scott-williams-xentronics/CanberraGrammarSchool-OrienteeringDevice/Schematic.pdf

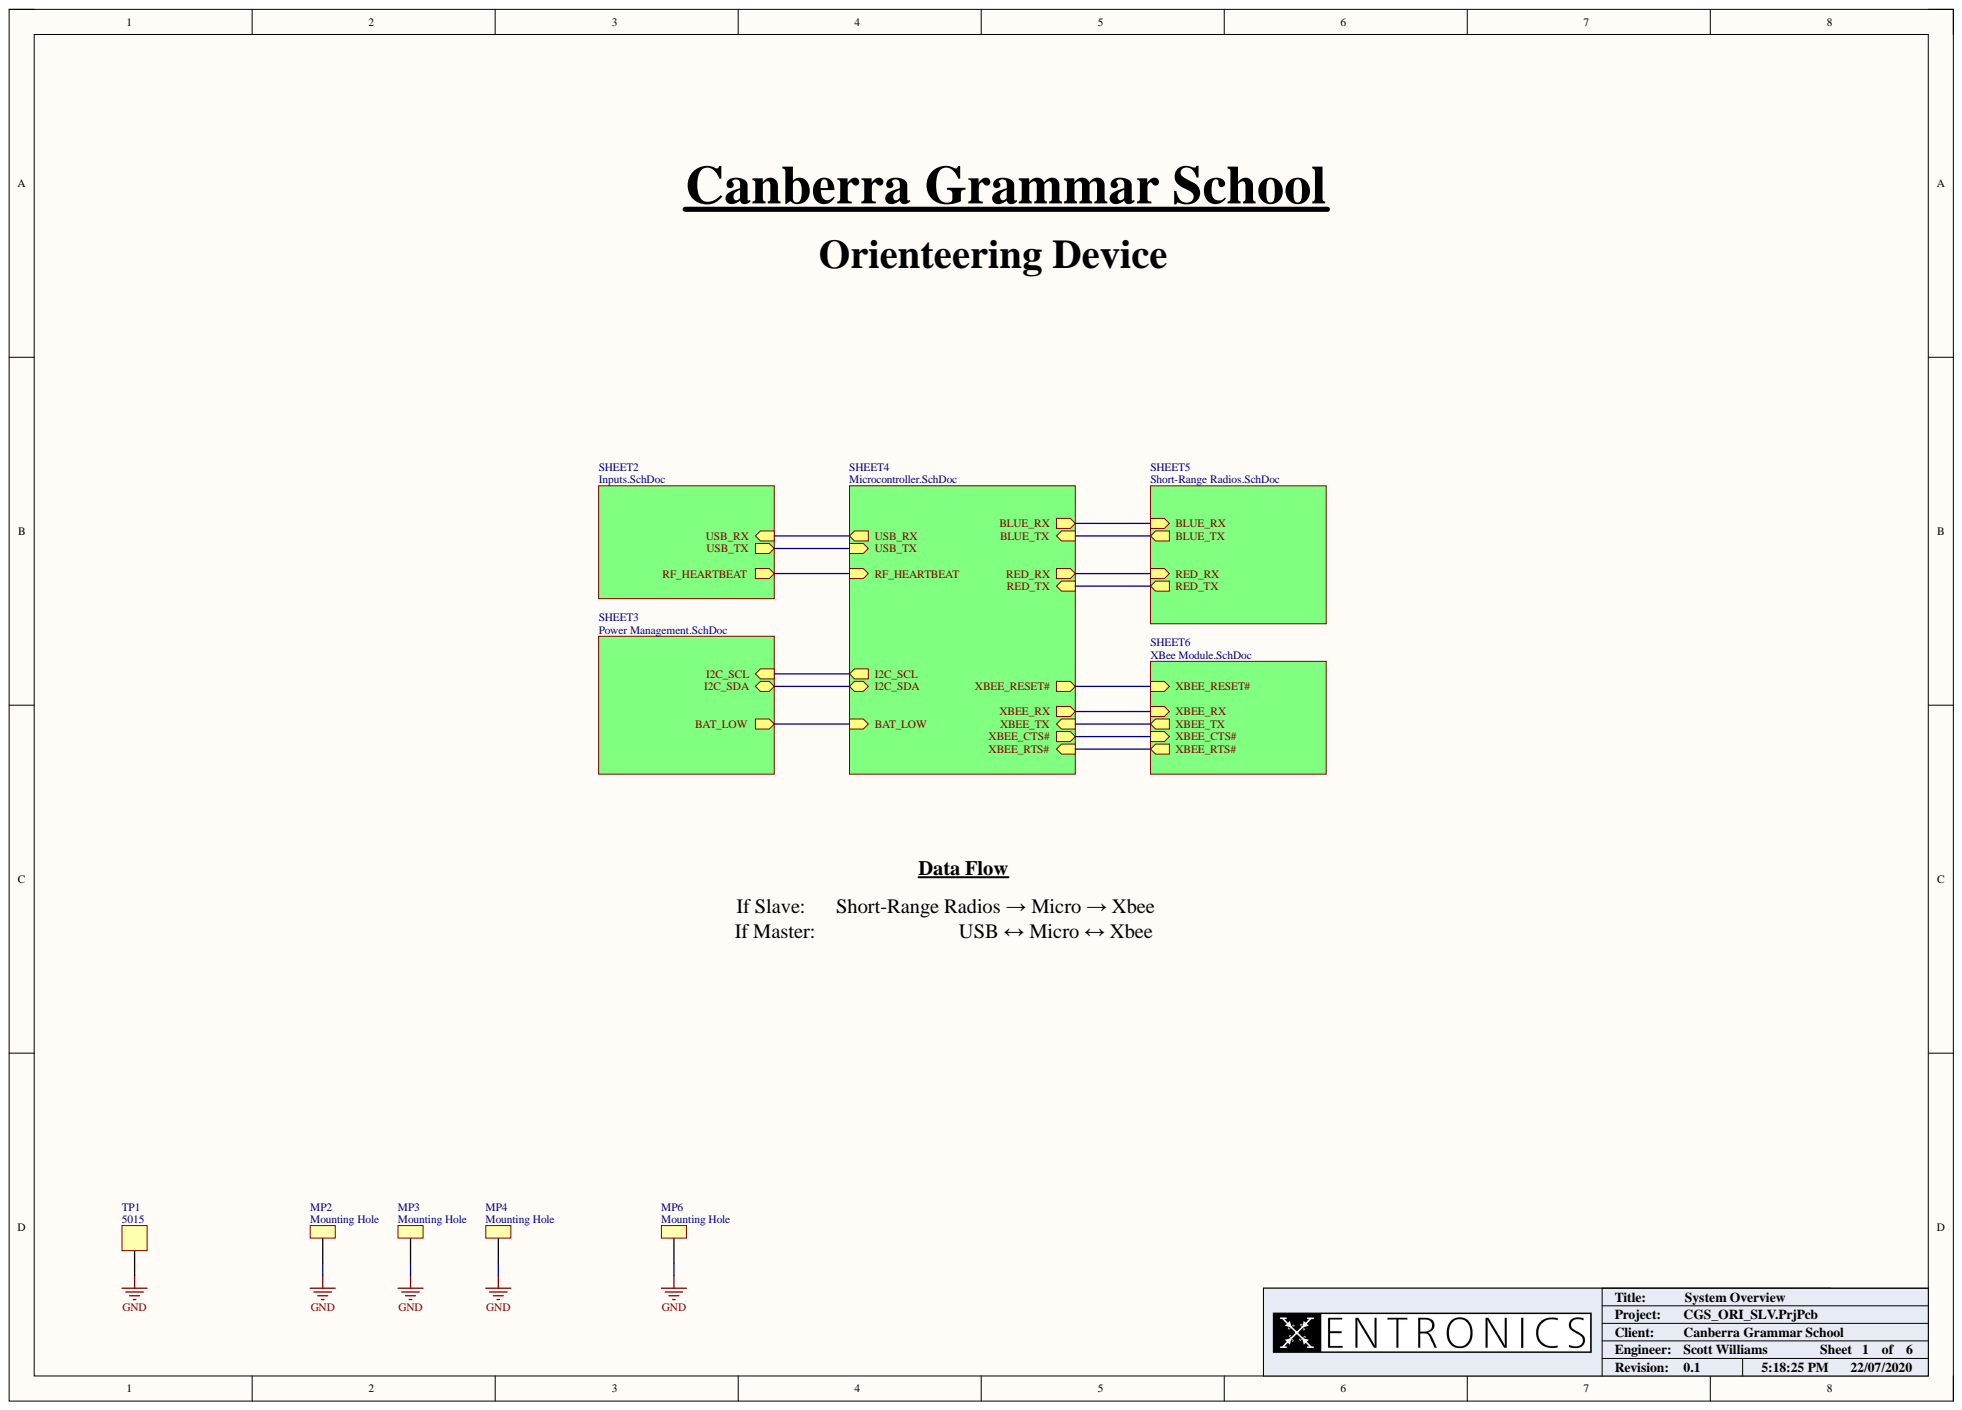
[picture p1: page 1]

SHEET5
Short-Range Radios.SchDoc

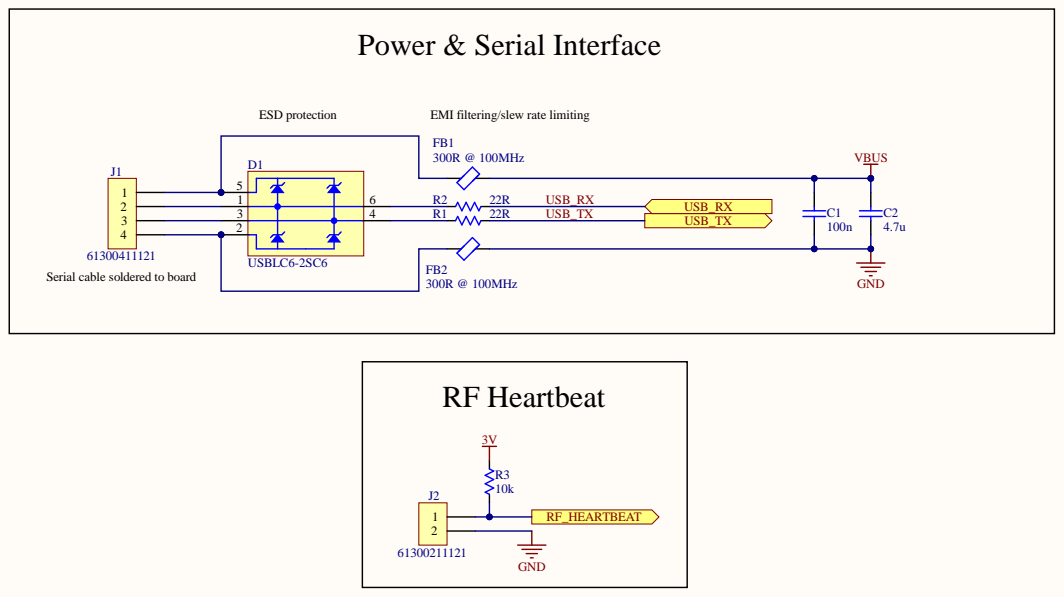
[picture p2: page 2]

Serial cable soldered to board

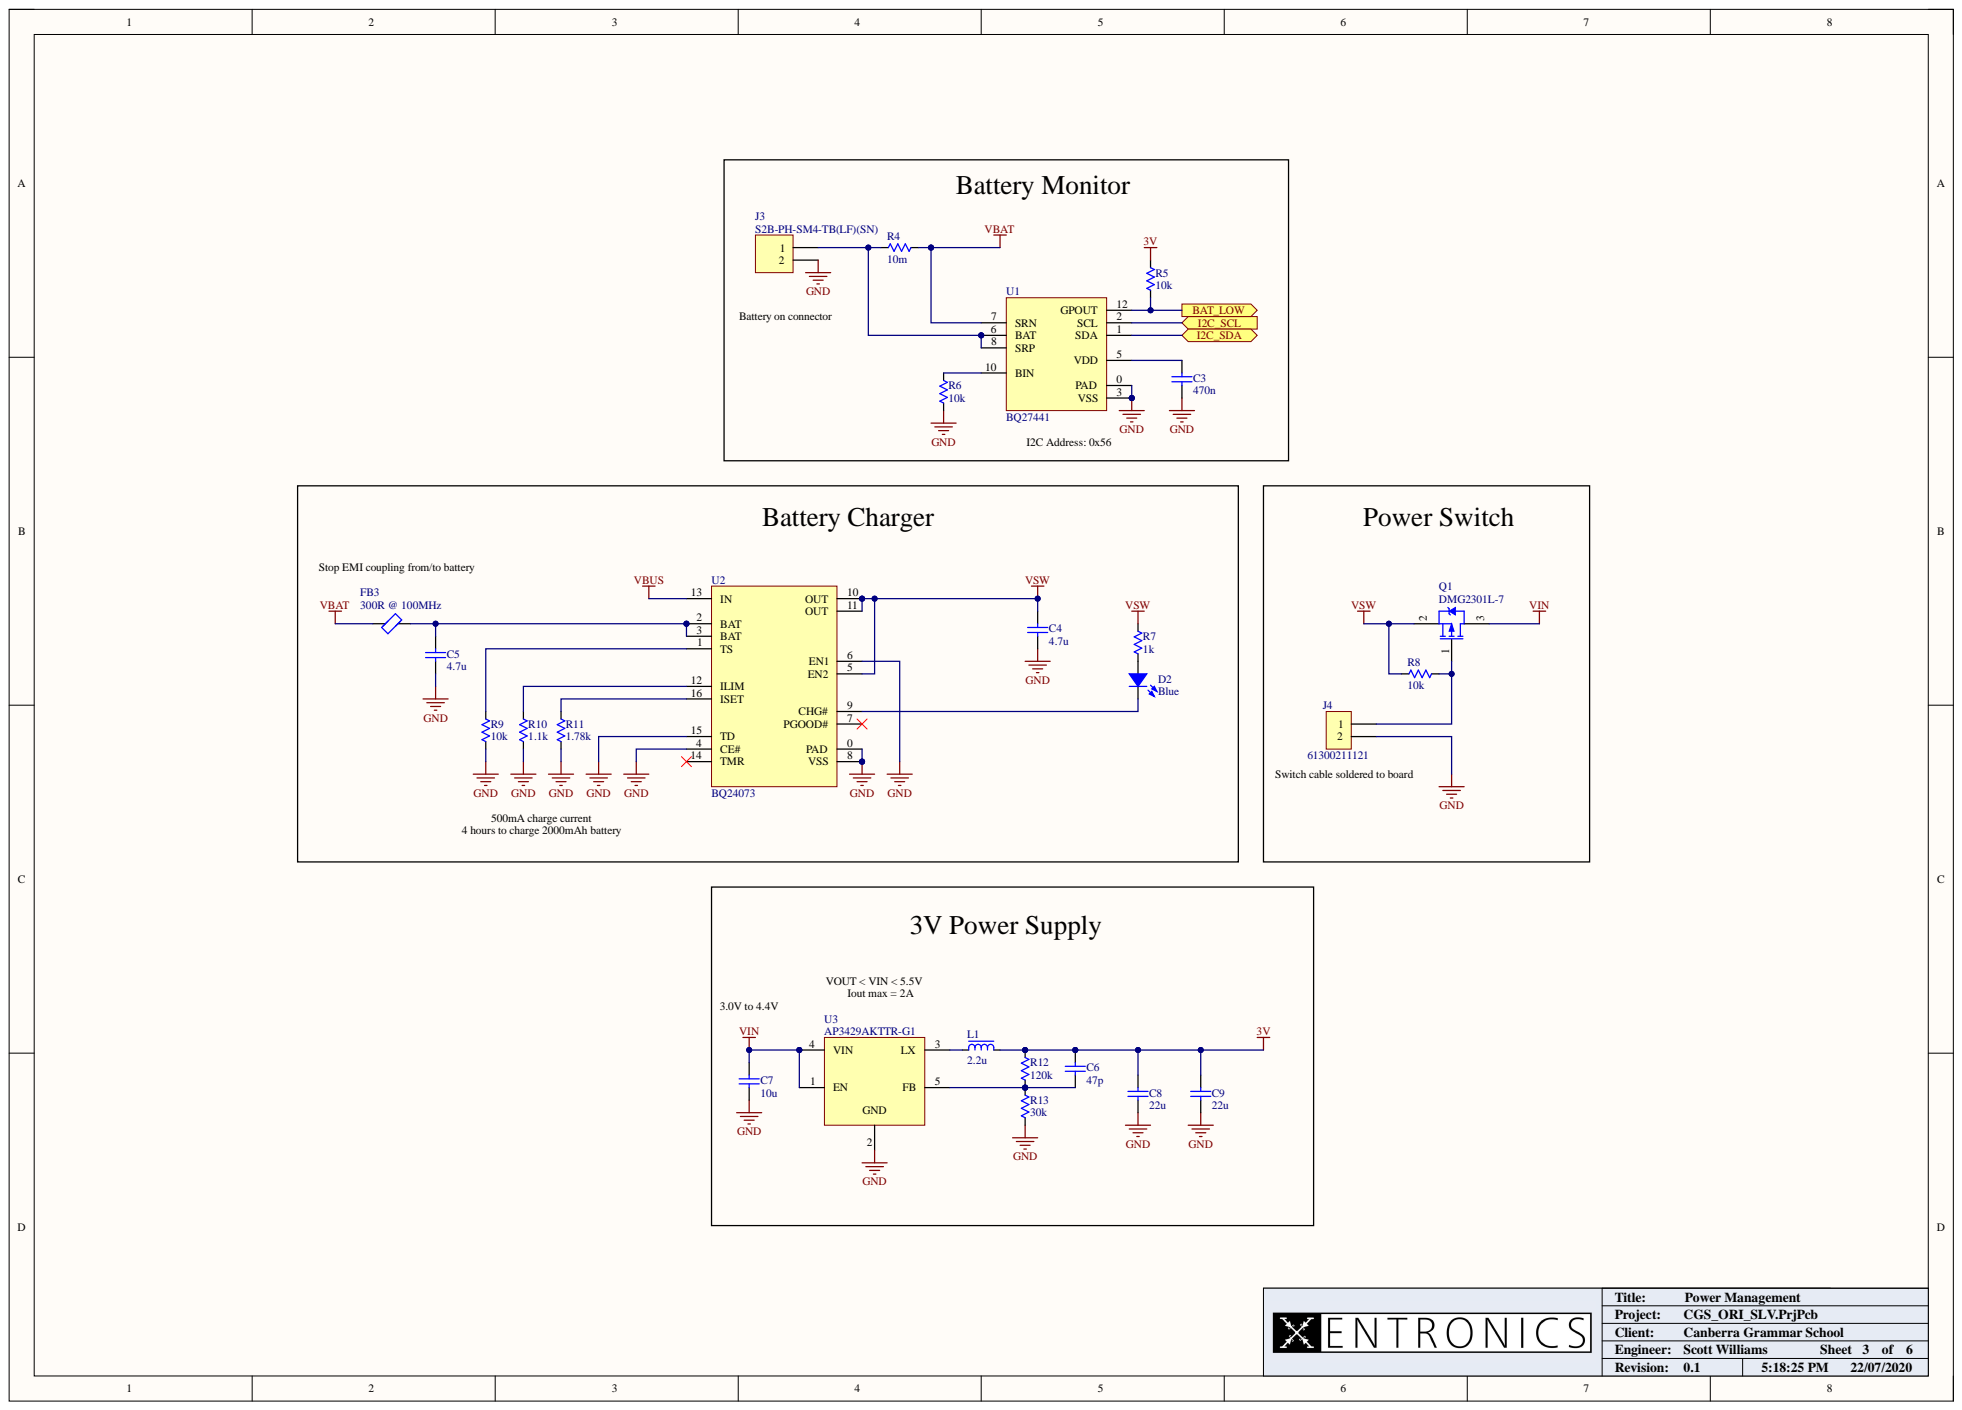
[picture p3: page 3]

Stop EMI coupling from/to battery

ILIM 12
ISET 16

Switch cable soldered to board

500mA charge current
4 hours to charge 2000mAh battery

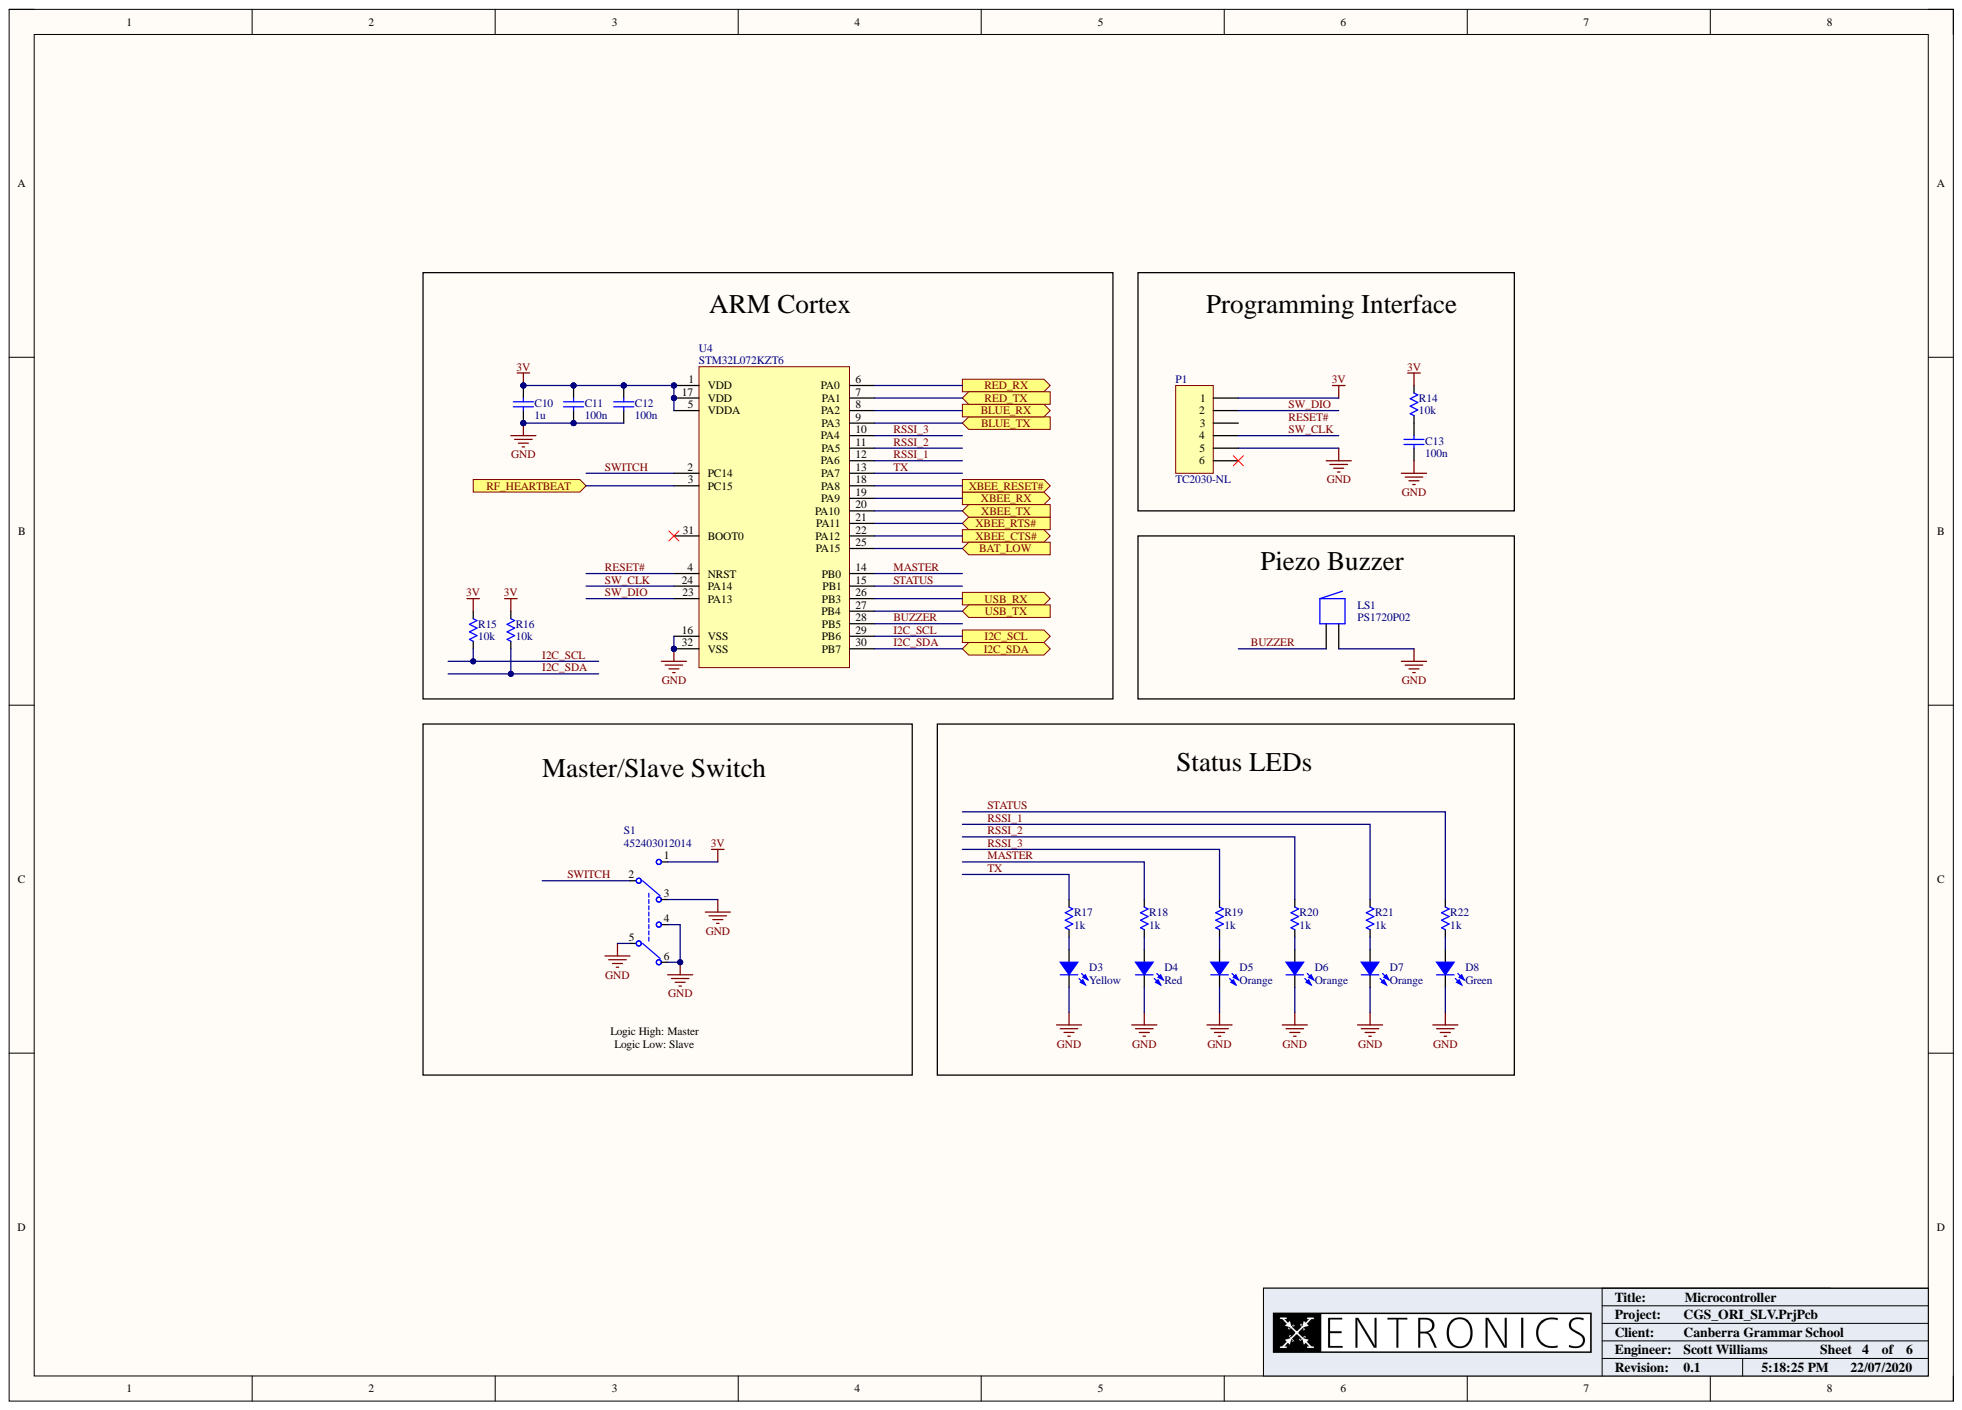
[picture p4: page 4]

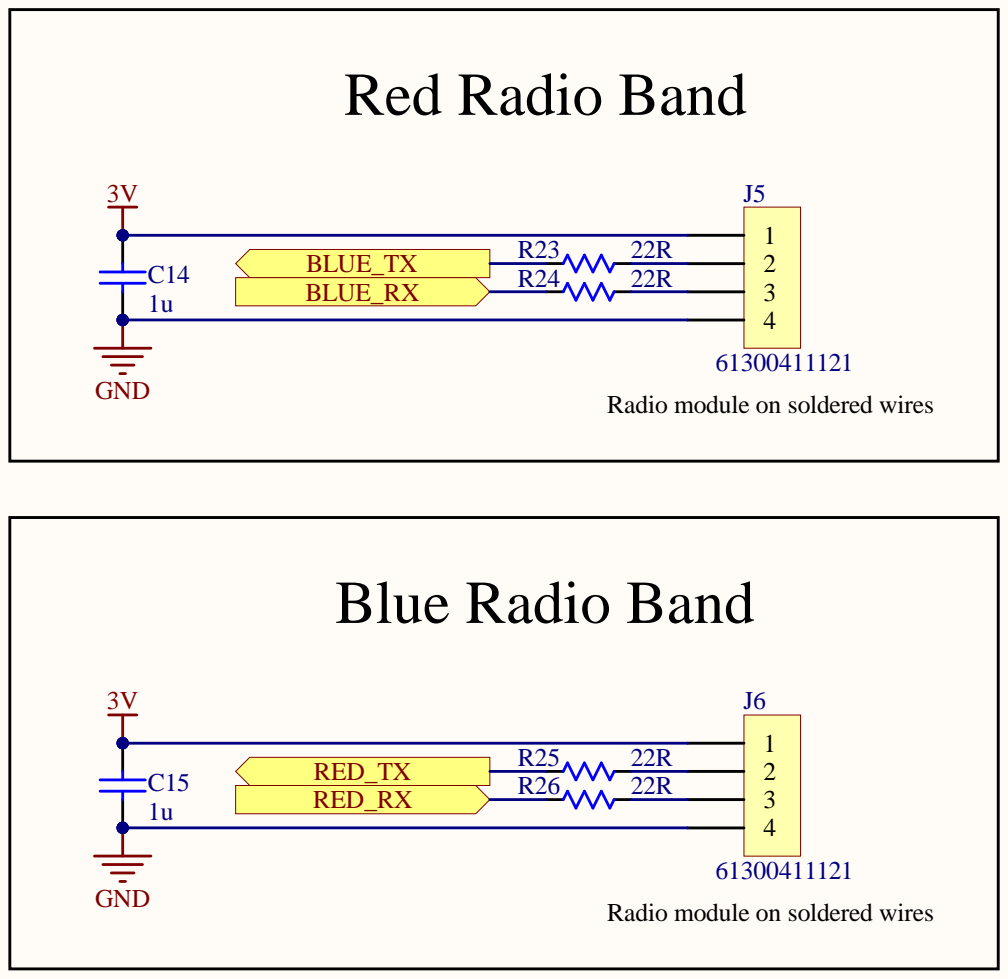
[picture p5: page 5]

Radio module on soldered wires

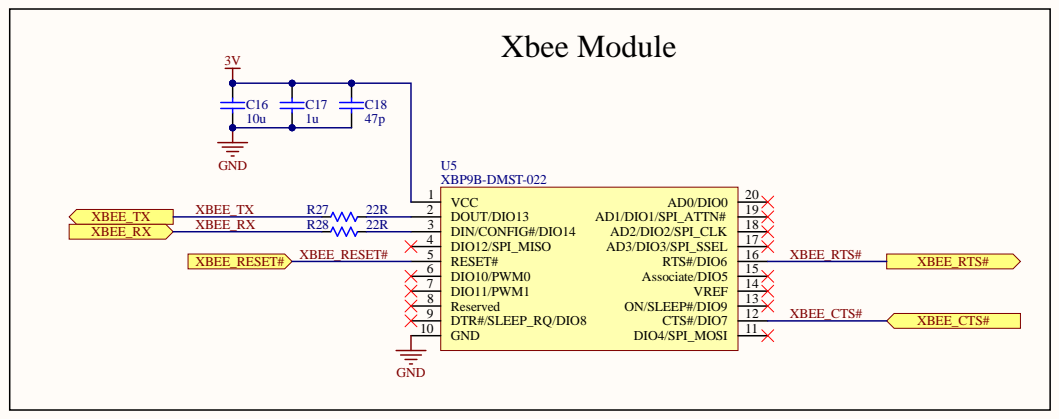
[picture p6: page 6]
